blmonk/PoE-Stepper-Motor-Driver/README.md

# PoE-Stepper-Motor-Driver
ECE445 Senior Design
