blmonk/PoE-Stepper-Motor-Driver/(list of files, drawings)

Other design files:
boards/References/Analog Devices DC2911A/DC2911A/DC2911A-1_post/DC2911A-1.DSN
boards/References/Analog Devices DC2911A/DC2911A/DC2911A-1_post/DC2911A-1.PCB
