blmonk/PoE-Stepper-Motor-Driver/boards/PoE_Stepper_Driver/PoE_Stepper_Driver.kicad_pcb

## KiCad design boards/PoE_Stepper_Driver/PoE_Stepper_Driver.kicad_pcb (2022-05-06)

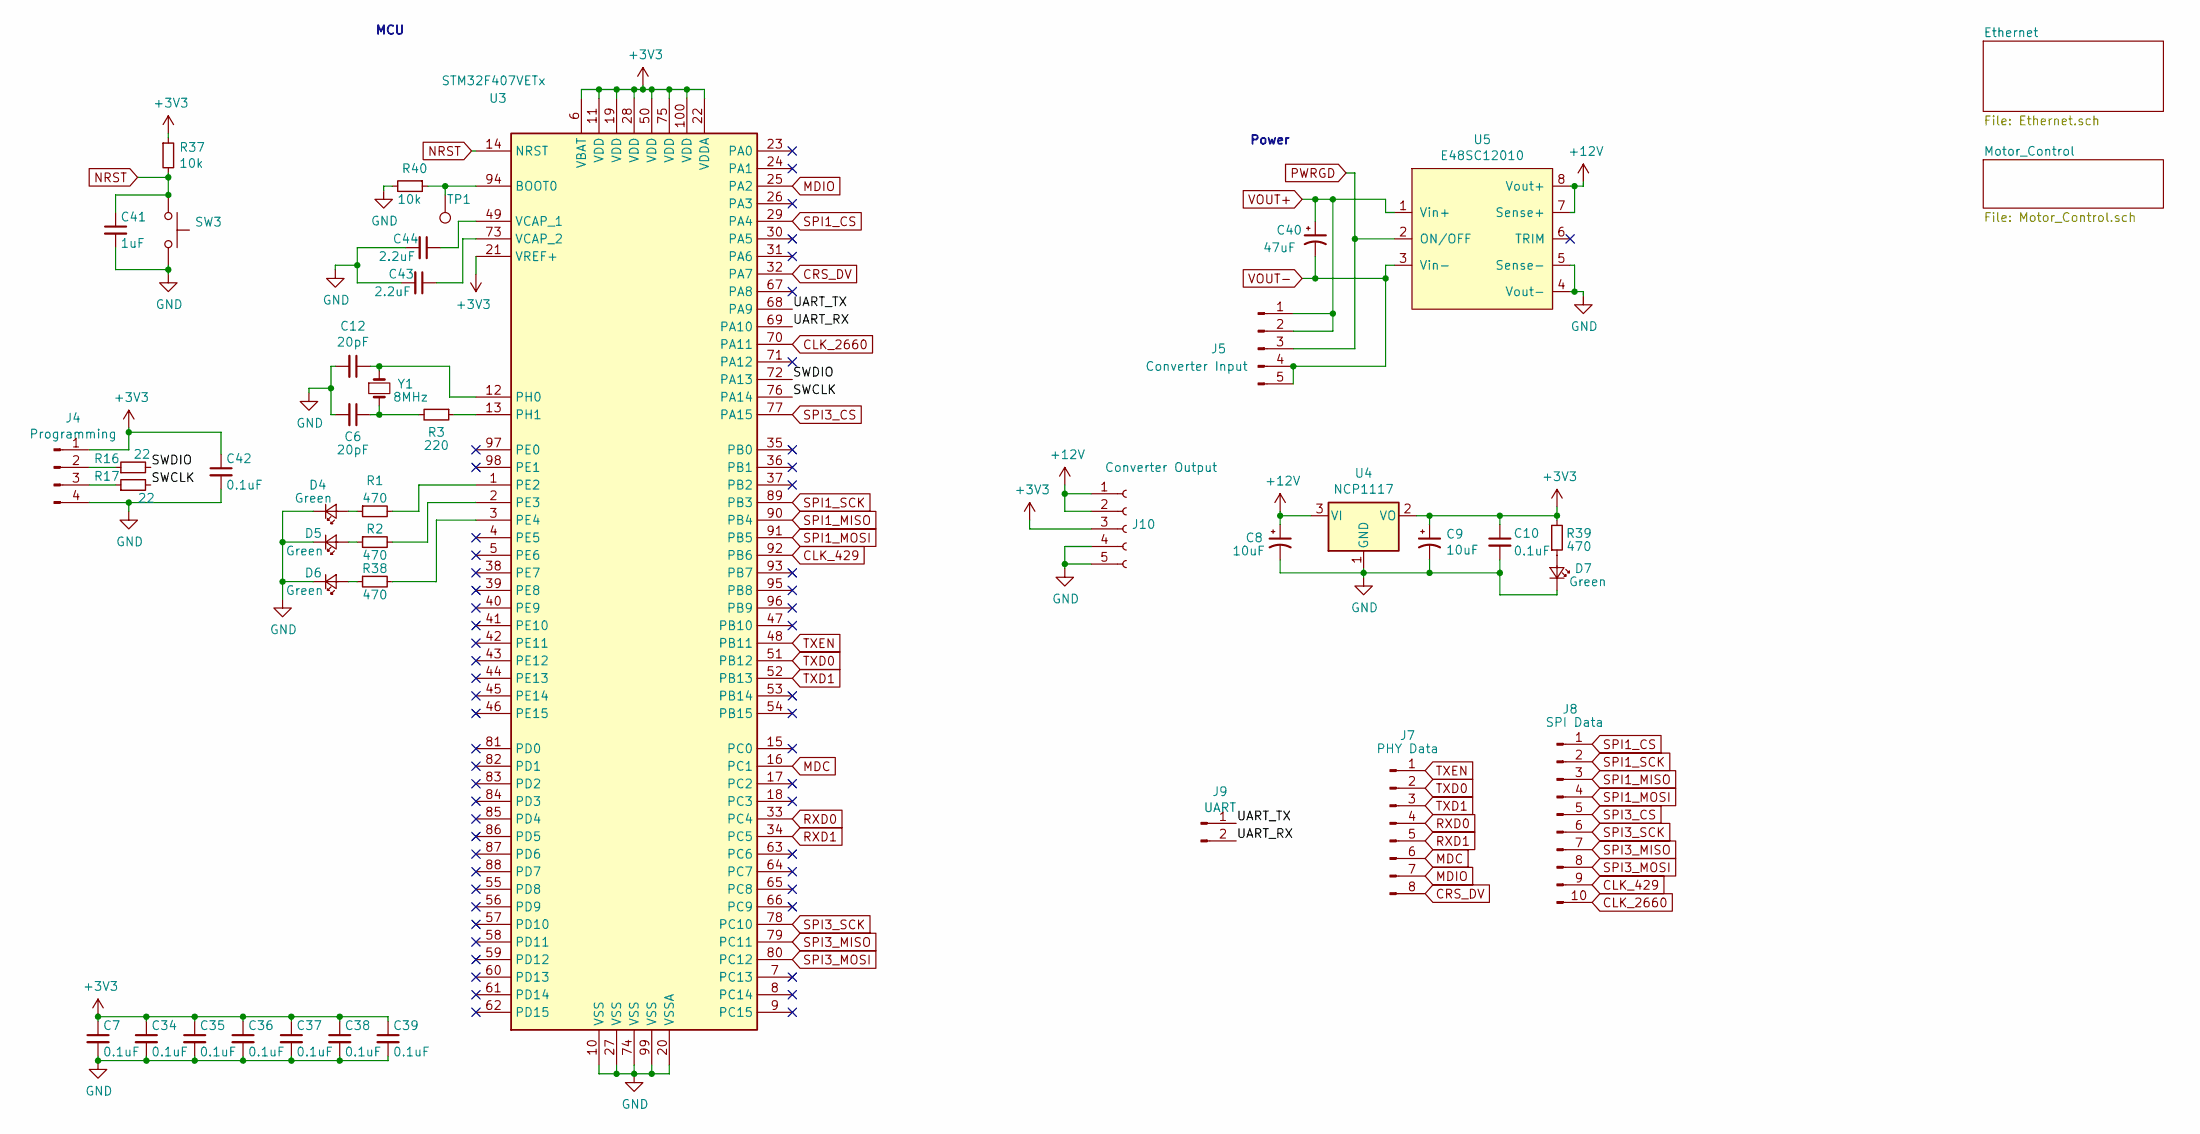
[picture p24: schematic PoE_Stepper_Driver.sch, PoE Stepper Driver]

Parts:
C6, C12: 20pF; C_0603_1608Metric_Pad1.05x0.95mm_HandSolder
C7, C10, C34, C35, C36, C37, C38, C39, C42: 0.1uF; C_0805_2012Metric_Pad1.15x1.40mm_HandSolder
C8, C9: 10uF; CP_Elec_6.3x5.4
C40: 47uF; CP_Radial_D8.0mm_P3.50mm
C41: 1uF; C_0805_2012Metric_Pad1.15x1.40mm_HandSolder
C43, C44: 2.2uF; C_0603_1608Metric_Pad1.05x0.95mm_HandSolder
D4, D5, D6, D7: Green; LED_0805_2012Metric_Pad1.15x1.40mm_HandSolder
J4: Programming; PinHeader_1x04_P2.54mm_Vertical
J5: Converter Input; PinHeader_1x05_P2.54mm_Vertical
J7: PHY Data; PinHeader_2x04_P2.54mm_Vertical
J8: SPI Data; PinHeader_2x05_P2.54mm_Vertical
J9: UART; PinHeader_1x02_P2.54mm_Vertical
J10: Converter Output; PinHeader_1x05_P2.54mm_Vertical
R1, R2, R38, R39: 470; R_0805_2012Metric_Pad1.15x1.40mm_HandSolder
R3: 220; R_0603_1608Metric_Pad1.05x0.95mm_HandSolder
R16, R17: 22; R_0805_2012Metric_Pad1.15x1.40mm_HandSolder
R37, R40: 10k; R_0805_2012Metric_Pad1.15x1.40mm_HandSolder
SW3: SW_Push; SW_SPST_B3S-1000
TP1: BOOT0; TestPoint_Pad_1.0x1.0mm
U3: STM32F407VETx; LQFP-100_14x14mm_P0.5mm
U4: NCP1117; SOT-223-3_TabPin2
U5: E48SC12010
Y1: 8MHz; Crystal_HC49-4H_Vertical

Connections:
+3V3: C7.1, C9.1, C10.1, C34.1, C35.1, C36.1, C37.1, C38.1, C39.1, C42.1, J4.1, J10.3, R37.1, R39.2, U3.6 (VBAT), U3.11 (VDD), U3.19 (VDD), U3.21 (VREF+), U3.22 (VDDA), U3.28 (VDD), U3.50 (VDD), U3.75 (VDD), U3.100 (VDD), U4.2 (VO); also elsewhere on the board
+12V: C8.1, J10.1, J10.2, U4.3 (VI), U5.7 (Sense+), U5.8 (Vout+); also elsewhere on the board
/SWCLK: R17.2, U3.76 (PA14)
/SWDIO: R16.2, U3.72 (PA13)
/UART_RX: J9.2, U3.69 (PA10)
/UART_TX: J9.1, U3.68 (PA9)
CLK_429: J8.9, U3.92 (PB6); also elsewhere on the board
CLK_2660: J8.10, U3.70 (PA11); also elsewhere on the board
CRS_DV: J7.8, U3.32 (PA7); also elsewhere on the board
GND: C6.2, C7.2, C8.2, C9.2, C10.2, C12.2, C34.2, C35.2, C36.2, C37.2, C38.2, C39.2, C41.2, C42.2, C43.2, C44.2, D4.1 (K), D5.1 (K), D6.1 (K), D7.1 (K), J4.4, J10.4, J10.5, R40.2, SW3.2, U3.10 (VSS), U3.20 (VSSA), U3.27 (VSS), U3.74 (VSS), U3.99 (VSS), U4.1 (GND), U5.4 (Vout-), U5.5 (Sense-); also elsewhere on the board
MDC: J7.6, U3.16 (PC1); also elsewhere on the board
MDIO: J7.7, U3.25 (PA2); also elsewhere on the board
NRST: C41.1, R37.2, SW3.1, U3.14 (NRST); also elsewhere on the board
unnamed: C6.1, R3.2, Y1.2
unnamed: C12.1, U3.12 (PH0), Y1.1
unnamed: C43.1, U3.73 (VCAP_2)
unnamed: C44.1, U3.49 (VCAP_1)
unnamed: D4.2 (A), R1.1
unnamed: D5.2 (A), R2.1
unnamed: D6.2 (A), R38.1
unnamed: D7.2 (A), R39.1
unnamed: J4.2, R16.1
unnamed: J4.3, R17.1
unnamed: R1.2, U3.1 (PE2)
unnamed: R2.2, U3.2 (PE3)
unnamed: R3.1, U3.13 (PH1)
unnamed: R38.2, U3.3 (PE4)
unnamed: R40.1, TP1.1, U3.94 (BOOT0)
PWRGD: J5.3, U5.2 (ON/OFF); also elsewhere on the board
RXD0: J7.4, U3.33 (PC4); also elsewhere on the board
RXD1: J7.5, U3.34 (PC5); also elsewhere on the board
SPI1_CS: J8.1, U3.29 (PA4); also elsewhere on the board
SPI1_MISO: J8.3, U3.90 (PB4); also elsewhere on the board
SPI1_MOSI: J8.4, U3.91 (PB5); also elsewhere on the board
SPI1_SCK: J8.2, U3.89 (PB3); also elsewhere on the board
SPI3_CS: J8.5, U3.77 (PA15); also elsewhere on the board
SPI3_MISO: J8.7, U3.79 (PC11); also elsewhere on the board
SPI3_MOSI: J8.8, U3.80 (PC12); also elsewhere on the board
SPI3_SCK: J8.6, U3.78 (PC10); also elsewhere on the board
TXD0: J7.2, U3.51 (PB12); also elsewhere on the board
TXD1: J7.3, U3.52 (PB13); also elsewhere on the board
TXEN: J7.1, U3.48 (PB11); also elsewhere on the board
VOUT+: C40.1, J5.1, J5.2, U5.1 (Vin+); also elsewhere on the board
VOUT-: C40.2, J5.4, J5.5, U5.3 (Vin-); also elsewhere on the board

Notes on the sheet:
Power
MCU

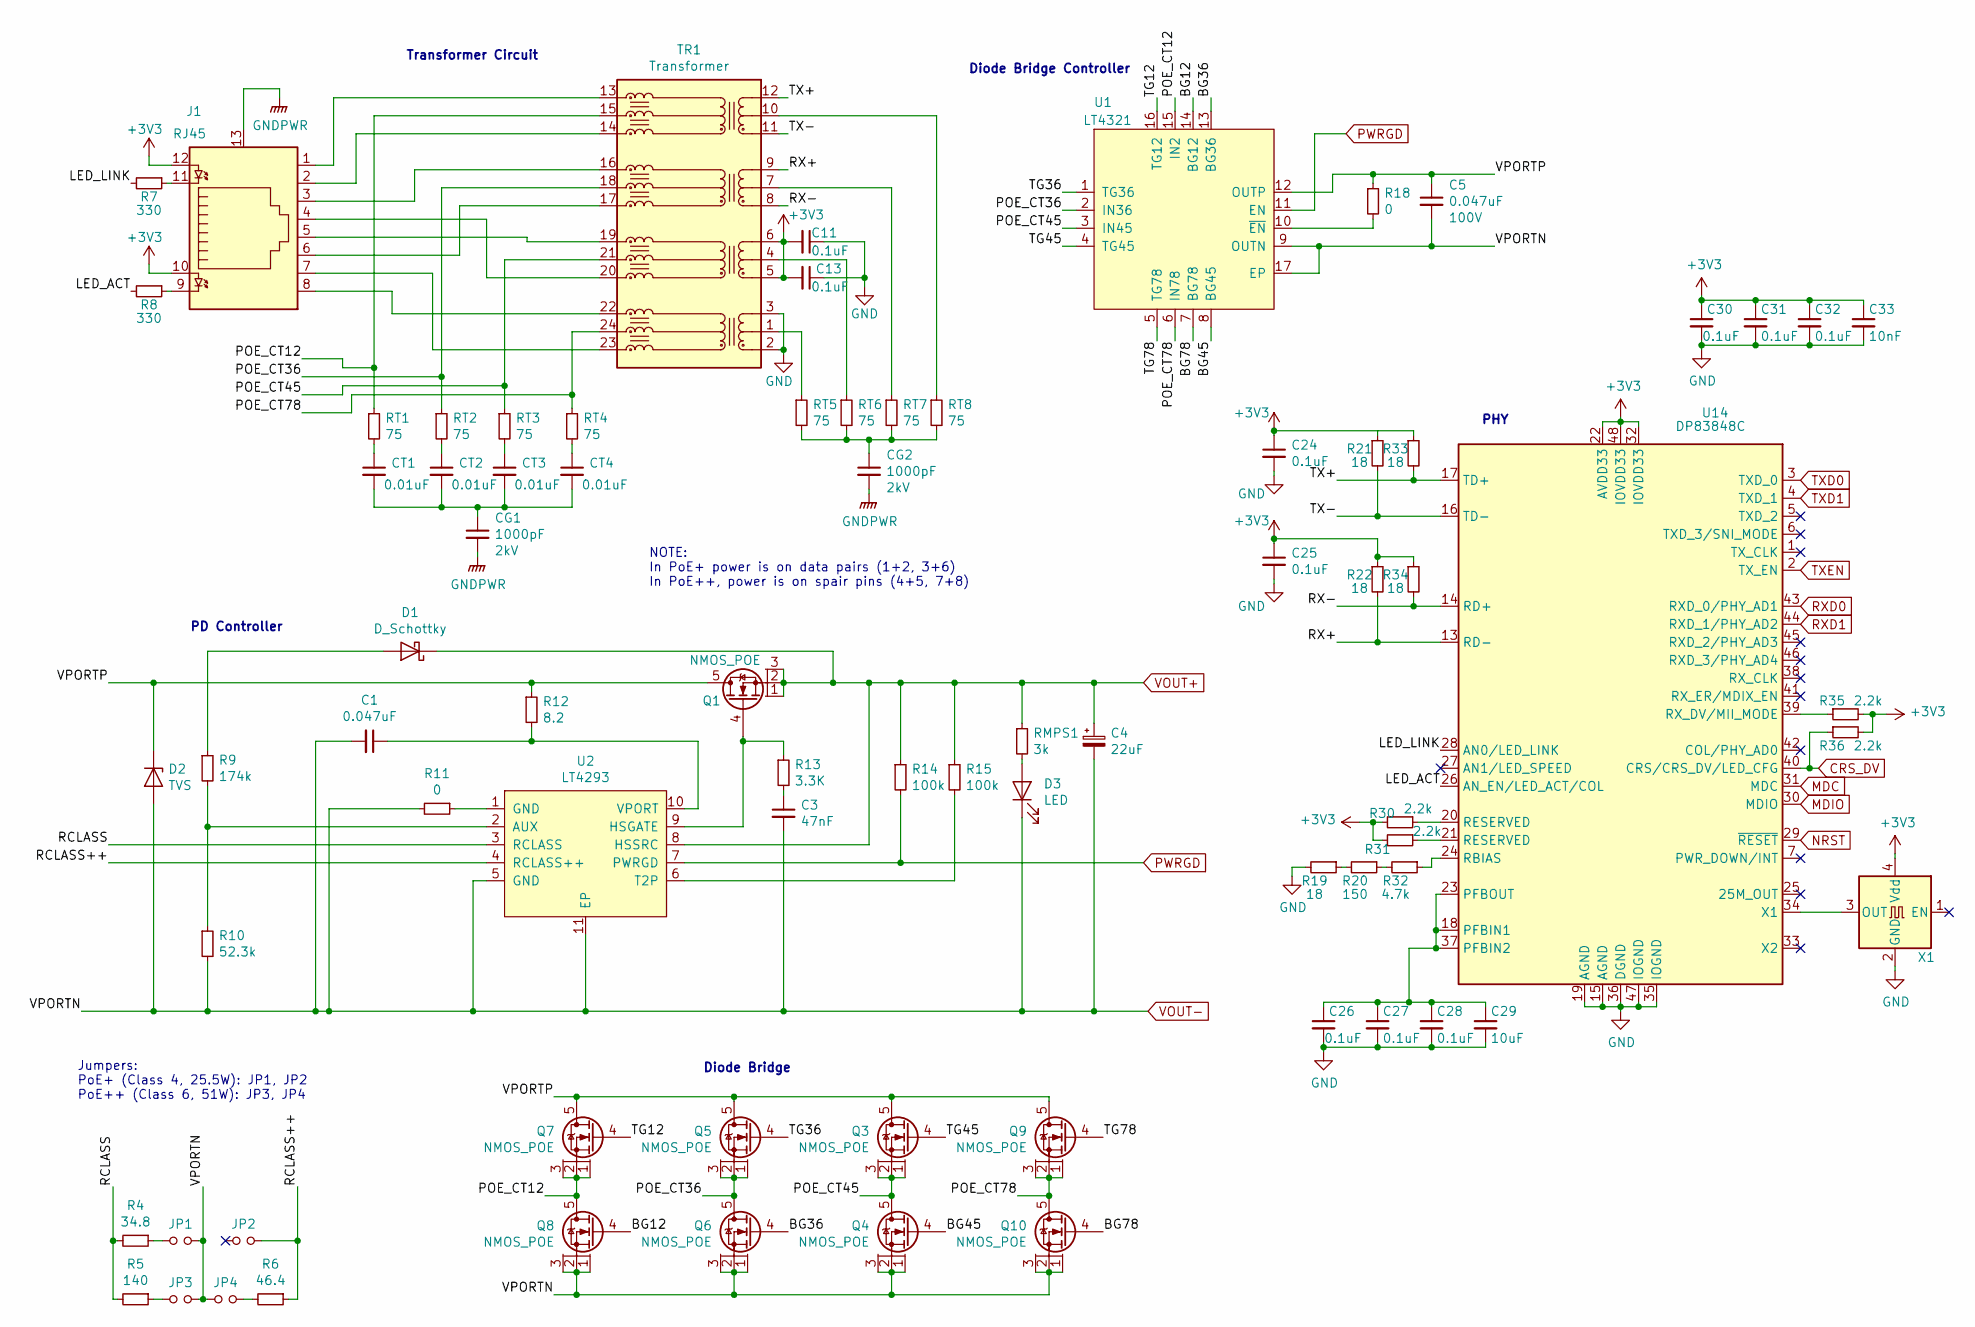
[picture p25: schematic Ethernet.sch, PoE Stepper Driver]

Parts:
C1: 0.047uF; C_0603_1608Metric_Pad1.05x0.95mm_HandSolder
C3: 47nF; C_0805_2012Metric_Pad1.15x1.40mm_HandSolder
C4: 22uF; CP_Elec_8x10.5
C5: 0.047uF; C_0603_1608Metric_Pad1.05x0.95mm_HandSolder; Voltage 100V
C11, C13, C24, C25, C26, C27, C28, C30, C31, C32: 0.1uF; C_0805_2012Metric_Pad1.15x1.40mm_HandSolder
C29: 10uF; C_0805_2012Metric_Pad1.15x1.40mm_HandSolder
C33: 10nF; C_0805_2012Metric_Pad1.15x1.40mm_HandSolder
CG1, CG2: 1000pF; C_1812_4532Metric_Pad1.30x3.40mm_HandSolder; Voltage 2kV
CT1, CT2, CT3, CT4: 0.01uF; C_0805_2012Metric_Pad1.15x1.40mm_HandSolder
D1: D_Schottky; D_SOD-128
D2: TVS; D_SOD-128
D3: LED; LED_0805_2012Metric_Pad1.15x1.40mm_HandSolder
J1: RJ45; RJ45_Amphenol_RJMG1BD3B8K1ANR
JP1, JP2, JP3, JP4: Jumper_NO_Small; PinHeader_1x02_P2.54mm_Vertical
Q1, Q3, Q4, Q5, Q6, Q7, Q8, Q9, Q10: NMOS_POE; LFPAK33
R4: 34.8; R_0805_2012Metric_Pad1.15x1.40mm_HandSolder
R5: 140; R_0805_2012Metric_Pad1.15x1.40mm_HandSolder
R6: 46.4; R_0805_2012Metric_Pad1.15x1.40mm_HandSolder
R7, R8: 330; R_0805_2012Metric_Pad1.15x1.40mm_HandSolder
R9: 174k; R_0603_1608Metric_Pad1.05x0.95mm_HandSolder
R10: 52.3k; R_0603_1608Metric_Pad1.05x0.95mm_HandSolder
R11, R18: 0; R_0603_1608Metric_Pad1.05x0.95mm_HandSolder
R12: 8.2; R_0805_2012Metric_Pad1.15x1.40mm_HandSolder
R13: 3.3K; R_0603_1608Metric_Pad1.05x0.95mm_HandSolder
R14, R15: 100k; R_0603_1608Metric_Pad1.05x0.95mm_HandSolder
R19, R21, R22, R33, R34: 18; R_0805_2012Metric_Pad1.15x1.40mm_HandSolder
R20: 150; R_0805_2012Metric_Pad1.15x1.40mm_HandSolder
R30, R31, R35, R36: 2.2k; R_0805_2012Metric_Pad1.15x1.40mm_HandSolder
R32: 4.7k; R_0805_2012Metric_Pad1.15x1.40mm_HandSolder
RMPS1: 3k; R_2512_6332Metric_Pad1.52x3.35mm_HandSolder
RT1, RT2, RT3, RT4, RT5, RT6, RT7, RT8: 75; R_0603_1608Metric_Pad1.05x0.95mm_HandSolder
TR1: Transformer; PoE_Transformer
U1: LT4321; QFN-16-1EP_4x4mm_P0.65mm_EP2.15x2.15mm
U2: LT4293; MSOP-10_3x3mm_P0.5mm
U14: DP83848C; LQFP-48_7x7mm_P0.5mm
X1: SXO53C

Connections:
+3V3: C11.2, C13.2, C24.1, C25.1, C30.1, C31.1, C32.1, C33.1, J1.10, J1.12, R21.1, R22.1, R30.2, R31.2, R33.1, R34.1, R35.2, R36.2, TR1.5 (TD2+), TR1.6 (TD2-), U14.22 (AVDD33), U14.32 (IOVDD33), U14.48 (IOVDD33), X1.4 (Vdd); also elsewhere on the board
/Ethernet/BG12: Q8.4, U1.14 (BG12)
/Ethernet/BG36: Q6.4, U1.13 (BG36)
/Ethernet/BG45: Q4.4, U1.8 (BG45)
/Ethernet/BG78: Q10.4, U1.7 (BG78)
/Ethernet/LED_ACT: R8.2, U14.26 (AN_EN/LED_ACT/COL)
/Ethernet/LED_LINK: R7.2, U14.28 (AN0/LED_LINK)
/Ethernet/POE_CT12: Q7.1, Q7.2, Q7.3, Q8.5, RT1.1, TR1.15 (MCT4), U1.15 (IN2)
/Ethernet/POE_CT36: Q5.1, Q5.2, Q5.3, Q6.5, RT2.1, TR1.18 (MCT3), U1.2 (IN36)
/Ethernet/POE_CT45: Q3.1, Q3.2, Q3.3, Q4.5, RT3.1, TR1.21 (MCT2), U1.3 (IN45)
/Ethernet/POE_CT78: Q9.1, Q9.2, Q9.3, Q10.5, RT4.1, TR1.24 (MTC1), U1.6 (IN78)
/Ethernet/RCLASS: R4.2, R5.2, U2.3 (RCLASS)
/Ethernet/RCLASS++: JP2.2, R6.1, U2.4 (RCLASS++)
/Ethernet/RX+: R22.2, TR1.9 (TD3-), U14.13 (RD-)
/Ethernet/RX-: R34.2, TR1.8 (TD3+), U14.14 (RD+)
/Ethernet/TG12: Q7.4, U1.16 (TG12)
/Ethernet/TG36: Q5.4, U1.1 (TG36)
/Ethernet/TG45: Q3.4, U1.4 (TG45)
/Ethernet/TG78: Q9.4, U1.5 (TG78)
/Ethernet/TX+: R33.2, TR1.12 (TD4-), U14.17 (TD+)
/Ethernet/TX-: R21.2, TR1.11 (TD4+), U14.16 (TD-)
/Ethernet/VPORTP: C5.1, D2.1 (K), Q1.5, Q3.5, Q5.5, Q7.5, Q9.5, R12.1, R18.1, U1.12 (OUTP)
CRS_DV: R36.1, U14.40 (CRS/CRS_DV/LED_CFG); also elsewhere on the board
GND: C11.1, C13.1, C24.2, C25.2, C26.2, C27.2, C28.2, C29.2, C30.2, C31.2, C32.2, C33.2, R19.2, TR1.2 (TD1+), TR1.3 (TD1-), U14.15 (AGND), U14.19 (AGND), U14.35 (IOGND), U14.36 (DGND), U14.47 (IOGND), X1.2 (GND); also elsewhere on the board
GNDPWR: CG1.2, CG2.2, J1.13
MDC: U14.31 (MDC); also elsewhere on the board
MDIO: U14.30 (MDIO); also elsewhere on the board
NRST: U14.29 (~RESET~); also elsewhere on the board
unnamed: C1.1, R12.2, U2.10 (VPORT)
unnamed: C3.1, R13.2
unnamed: C26.1, C27.1, C28.1, C29.1, U14.18 (PFBIN1), U14.23 (PFBOUT), U14.37 (PFBIN2)
unnamed: CG1.1, CT1.2, CT2.2, CT3.2, CT4.2
unnamed: CG2.1, RT5.2, RT6.2, RT7.2, RT8.2
unnamed: CT1.1, RT1.2
unnamed: CT2.1, RT2.2
unnamed: CT3.1, RT3.2
unnamed: CT4.1, RT4.2
unnamed: D1.2 (A), R9.1
unnamed: D3.2 (A), RMPS1.2
unnamed: J1.1, TR1.13 (MX4-)
unnamed: J1.2, TR1.14 (MX4+)
unnamed: J1.3, TR1.16 (MTX3-)
unnamed: J1.4, TR1.20 (MTX2+)
unnamed: J1.5, TR1.19 (MTX2-)
unnamed: J1.6, TR1.17 (MTX3+)
unnamed: J1.7, TR1.23 (MTX1+)
unnamed: J1.8, TR1.22 (MTX1-)
unnamed: J1.9, R8.1
unnamed: J1.11, R7.1
unnamed: JP1.1, R4.1
unnamed: JP3.1, R5.1
unnamed: JP4.2, R6.2
unnamed: Q1.4, R13.1, U2.9 (HSGATE)
unnamed: R9.2, R10.1, U2.2 (AUX)
unnamed: R11.1, U2.1 (GND)
unnamed: R15.2, U2.6 (T2P)
unnamed: R18.2, U1.10 (~EN)
unnamed: R19.1, R20.2
unnamed: R20.1, R32.2
unnamed: R30.1, U14.20 (RESERVED)
unnamed: R31.1, U14.21 (RESERVED)
unnamed: R32.1, U14.24 (RBIAS)
unnamed: R35.1, U14.39 (RX_DV/MII_MODE)
unnamed: RT5.1, TR1.1 (TCT1)
unnamed: RT6.1, TR1.4 (TCT2)
unnamed: RT7.1, TR1.7 (TCT3)
unnamed: RT8.1, TR1.10 (TCT4)
unnamed: U14.34 (X1), X1.3 (OUT)
PWRGD: R14.2, U1.11 (EN), U2.7 (PWRGD); also elsewhere on the board
RXD0: U14.43 (RXD_0/PHY_AD1); also elsewhere on the board
RXD1: U14.44 (RXD_1/PHY_AD2); also elsewhere on the board
TXD0: U14.3 (TXD_0); also elsewhere on the board
TXD1: U14.4 (TXD_1); also elsewhere on the board
TXEN: U14.2 (TX_EN); also elsewhere on the board
VOUT+: C4.1, D1.1 (K), Q1.1, Q1.2, Q1.3, R14.1, R15.1, RMPS1.1, U2.8 (HSSRC); also elsewhere on the board
VOUT-: C1.2, C3.2, C4.2, C5.2, D2.2 (A), D3.1 (K), JP1.2, JP3.2, JP4.1, Q4.1, Q4.2, Q4.3, Q6.1, Q6.2, Q6.3, Q8.1, Q8.2, Q8.3, Q10.1, Q10.2, Q10.3, R10.2, R11.2, U1.9 (OUTN), U1.17 (EP), U2.5 (GND), U2.11 (EP); also elsewhere on the board

Notes on the sheet:
Jumpers: PoE+ (Class 4, 25.5W): JP1, JP2 PoE++ (Class 6, 51W): JP3, JP4
Diode Bridge Controller
Transformer Circuit
PD Controller
Diode Bridge
NOTE: In PoE+ power is on data pairs (1+2, 3+6) In PoE++, power is on spair pins (4+5, 7+8)
PHY

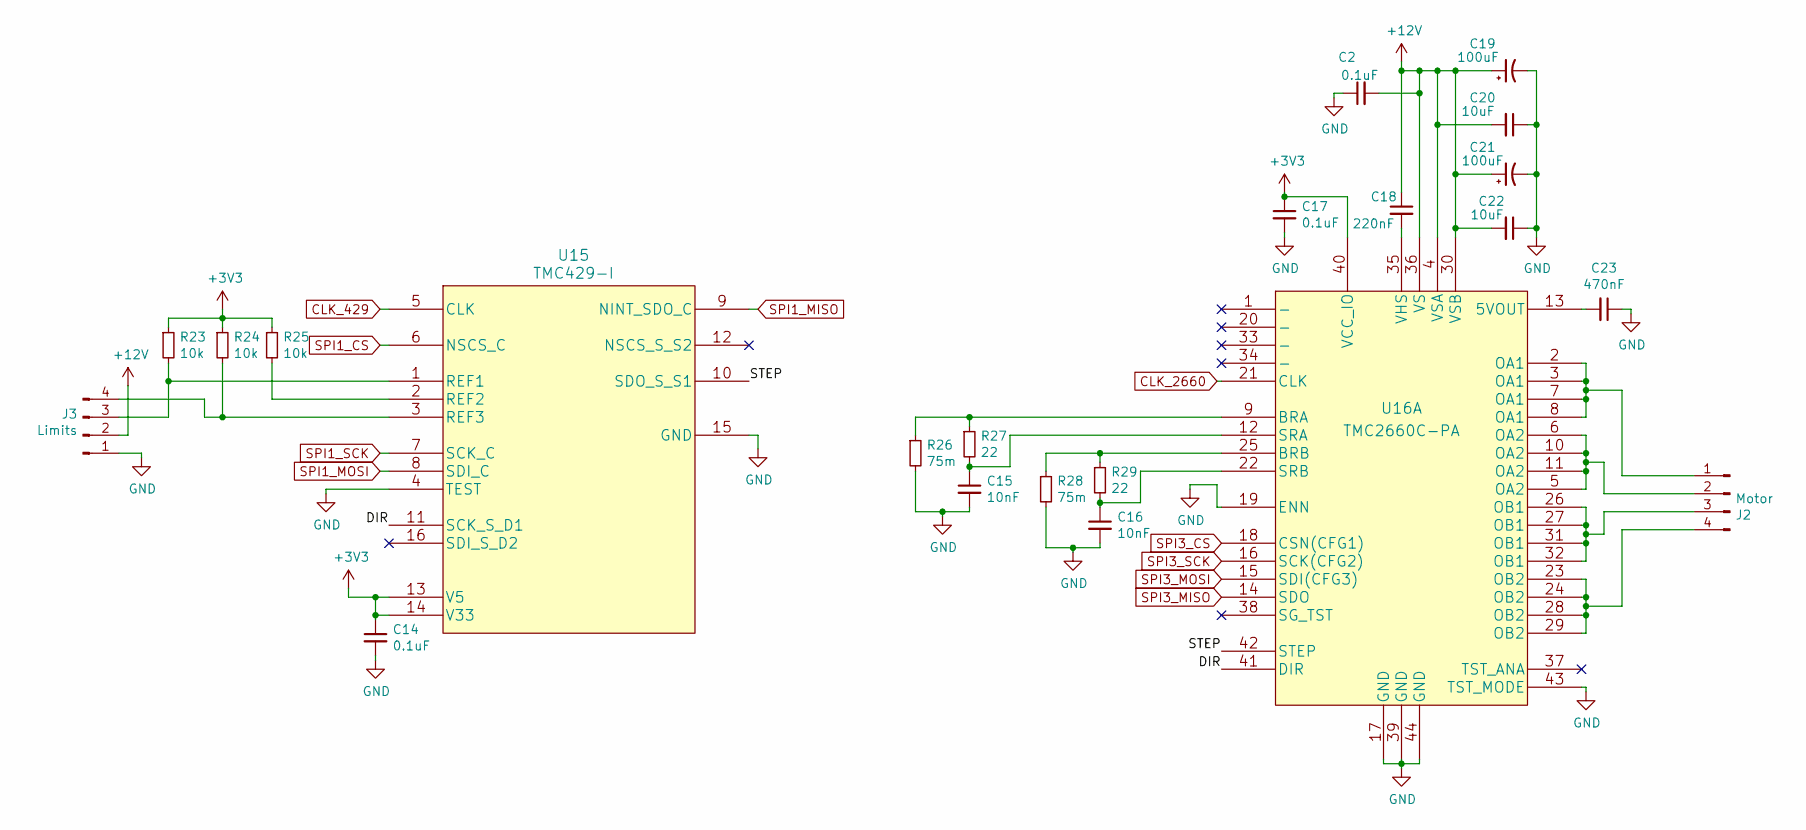
[picture p26: schematic Motor_Control.sch, PoE Stepper Driver]

Parts:
C2, C14, C17: 0.1uF; C_0805_2012Metric_Pad1.15x1.40mm_HandSolder
C15, C16: 10nF; C_0805_2012Metric_Pad1.15x1.40mm_HandSolder
C18: 220nF; C_0805_2012Metric_Pad1.15x1.40mm_HandSolder
C19, C21: 100uF; CP_Radial_D8.0mm_P3.50mm
C20, C22: 10uF; C_1206_3216Metric_Pad1.42x1.75mm_HandSolder
C23: 470nF; C_0805_2012Metric_Pad1.15x1.40mm_HandSolder
J2: Motor; JST_PH_B4B-PH-K_1x04_P2.00mm_Vertical
J3: Limits; JST_PH_B4B-PH-K_1x04_P2.00mm_Vertical
R23, R24, R25: 10k; R_0805_2012Metric_Pad1.15x1.40mm_HandSolder
R26, R28: 75m; R_2010_5025Metric_Pad1.52x2.65mm_HandSolder
R27, R29: 22; R_0805_2012Metric_Pad1.15x1.40mm_HandSolder
U15: TMC429-I; SSOP-16_3.9x4.9mm_P0.635mm
U16: TMC2660C-PA; PQFP-44_10x10mm_P0.8mm

Connections:
+3V3: C14.1, C17.1, R23.1, R24.1, R25.1, U15.13 (V5), U15.14 (V33), U16.40 (VCC_IO); also elsewhere on the board
+12V: C2.2, C18.1, C19.1, C20.2, C21.1, C22.2, J3.2, U16.4 (VSA), U16.30 (VSB), U16.36 (VS); also elsewhere on the board
/Motor_Control/DIR: U15.11 (SCK_S_D1), U16.41 (DIR)
/Motor_Control/STEP: U15.10 (SDO_S_S1), U16.42 (STEP)
CLK_429: U15.5 (CLK); also elsewhere on the board
CLK_2660: U16.21 (CLK); also elsewhere on the board
GND: C2.1, C14.2, C15.2, C16.2, C17.2, C19.2, C20.1, C21.2, C22.1, C23.1, J3.1, R26.2, R28.2, U15.4 (TEST), U15.15 (GND), U16.17 (GND), U16.19 (ENN), U16.39 (GND), U16.43 (TST_MODE), U16.44 (GND); also elsewhere on the board
unnamed: C15.1, R27.2, U16.12 (SRA)
unnamed: C16.1, R29.2, U16.22 (SRB)
unnamed: C18.2, U16.35 (VHS)
unnamed: C23.2, U16.13 (5VOUT)
unnamed: J2.1, U16.2 (OA1), U16.3 (OA1), U16.7 (OA1), U16.8 (OA1)
unnamed: J2.2, U16.5 (OA2), U16.6 (OA2), U16.10 (OA2), U16.11 (OA2)
unnamed: J2.3, U16.26 (OB1), U16.27 (OB1), U16.31 (OB1), U16.32 (OB1)
unnamed: J2.4, U16.23 (OB2), U16.24 (OB2), U16.28 (OB2), U16.29 (OB2)
unnamed: J3.3, R23.2, U15.1 (REF1)
unnamed: J3.4, R24.2, U15.3 (REF3)
unnamed: R25.2, U15.2 (REF2)
unnamed: R26.1, R27.1, U16.9 (BRA)
unnamed: R28.1, R29.1, U16.25 (BRB)
SPI1_CS: U15.6 (NSCS_C); also elsewhere on the board
SPI1_MISO: U15.9 (NINT_SDO_C); also elsewhere on the board
SPI1_MOSI: U15.8 (SDI_C); also elsewhere on the board
SPI1_SCK: U15.7 (SCK_C); also elsewhere on the board
SPI3_CS: U16.18 (CSN(CFG1)); also elsewhere on the board
SPI3_MISO: U16.14 (SDO); also elsewhere on the board
SPI3_MOSI: U16.15 (SDI(CFG3)); also elsewhere on the board
SPI3_SCK: U16.16 (SCK(CFG2)); also elsewhere on the board

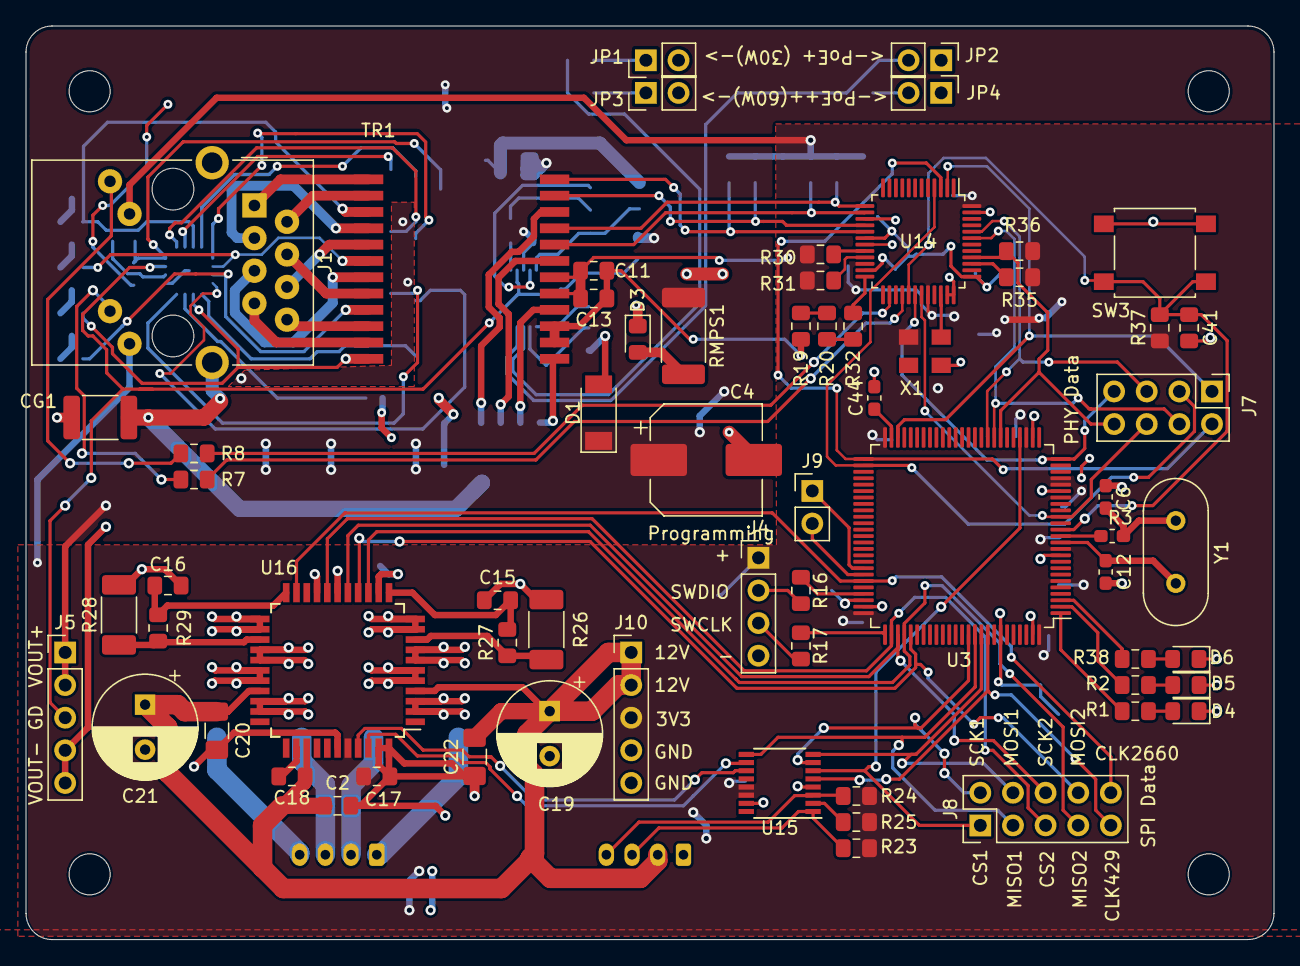
[picture p27: board PoE_Stepper_Driver.kicad_pcb from above]

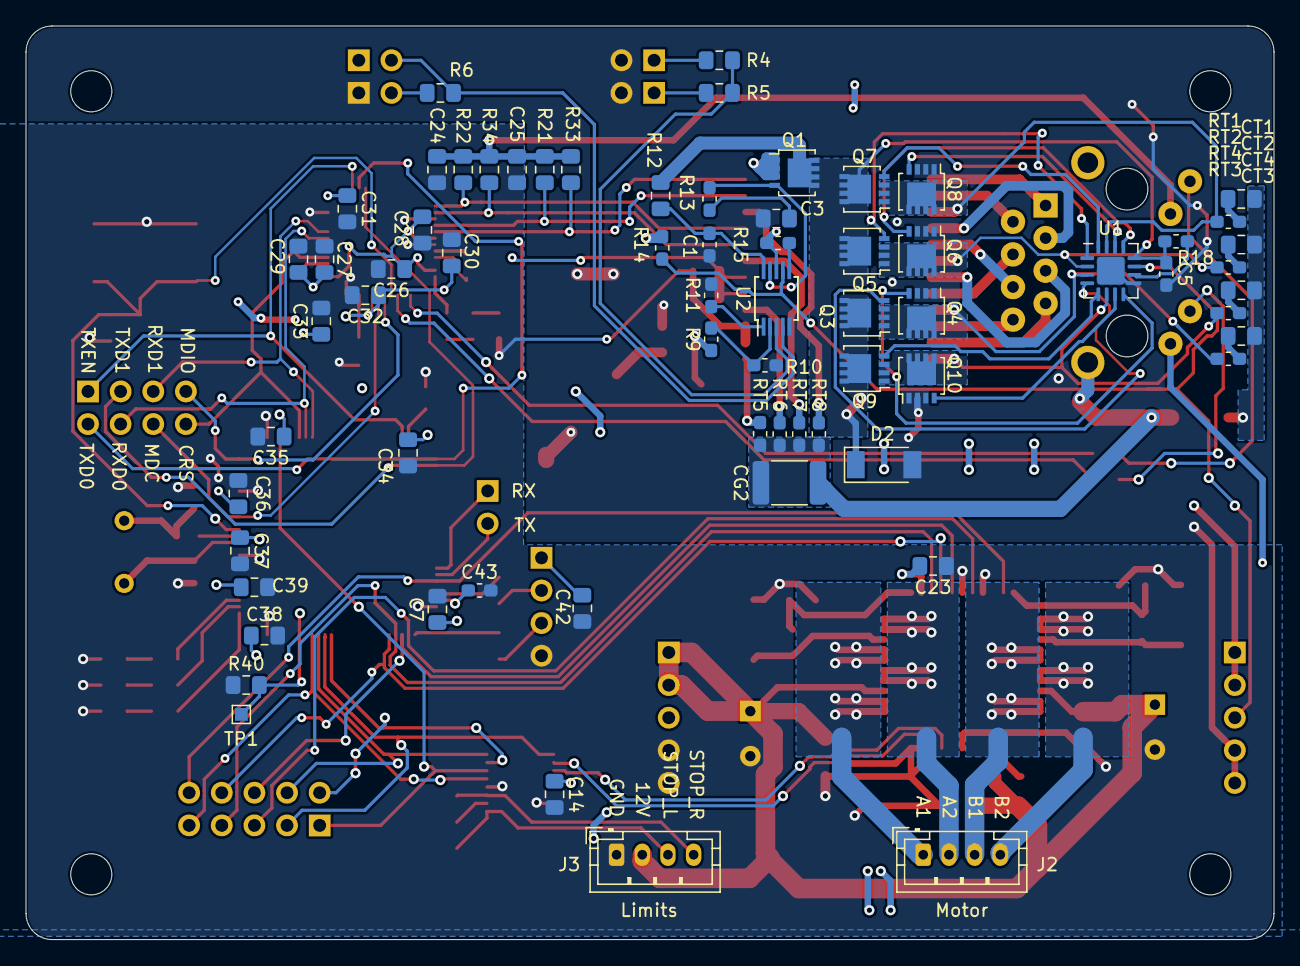
[picture p28: board PoE_Stepper_Driver.kicad_pcb from below]

Board: 2 copper layers, 97.2 x 71.1 mm, 133 parts (68 on the bottom side), 120 nets.
