blmonk/PoE-Stepper-Motor-Driver/boards/PoE_Stepper_Driver/Power_Board.kicad_pcb

## KiCad design boards/PoE_Stepper_Driver/Power_Board.kicad_pcb (2022-05-06)

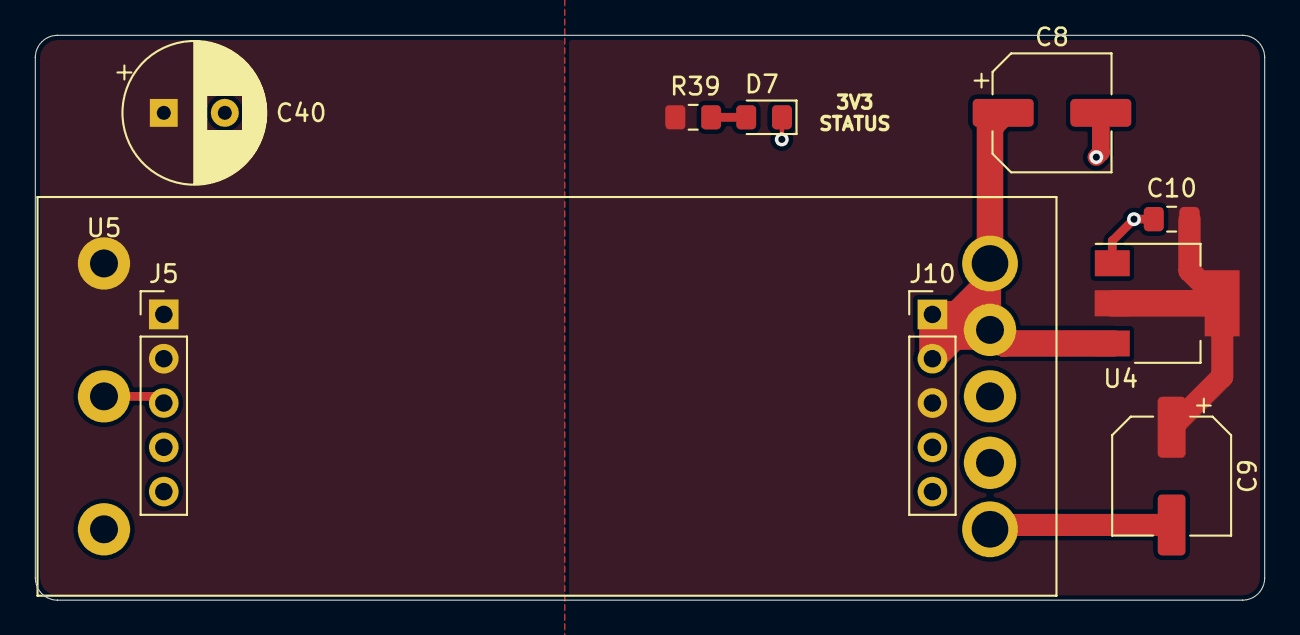
[picture p29: board Power_Board.kicad_pcb from above]

Board: 2 copper layers, 70.5 x 32.4 mm, 10 parts (0 on the bottom side), 7 nets.

Parts:
C8, C9: 10uF; CP_Elec_6.3x5.4
C10: 0.1uF; C_0805_2012Metric_Pad1.15x1.40mm_HandSolder
C40: 47uF; CP_Radial_D8.0mm_P3.50mm
D7: Green; LED_0805_2012Metric_Pad1.15x1.40mm_HandSolder
J5: Converter Input; PinHeader_1x05_P2.54mm_Vertical
J10: Converter Output; PinHeader_1x05_P2.54mm_Vertical
R39: 470; R_0805_2012Metric_Pad1.15x1.40mm_HandSolder
U4: NCP1117; SOT-223-3_TabPin2
U5: E48SC12010

Connections:
+3V3: C9.1, C10.1, J10.3, R39.2, U4.2
+12V: C8.1, J10.1, J10.2, U4.3, U5.7, U5.8
GND: C8.2, C9.2, C10.2, D7.1, J10.4, J10.5, U4.1, U5.4, U5.5
unnamed: D7.2, R39.1
PWRGD: J5.3, U5.2
VOUT+: C40.1, J5.1, J5.2, U5.1
VOUT-: C40.2, J5.4, J5.5, U5.3
