blmonk/PoE-Stepper-Motor-Driver/boards/PoE_Stepper_Driver/FET_Board.kicad_pcb

## KiCad design boards/PoE_Stepper_Driver/FET_Board.kicad_pcb (2022-03-30)

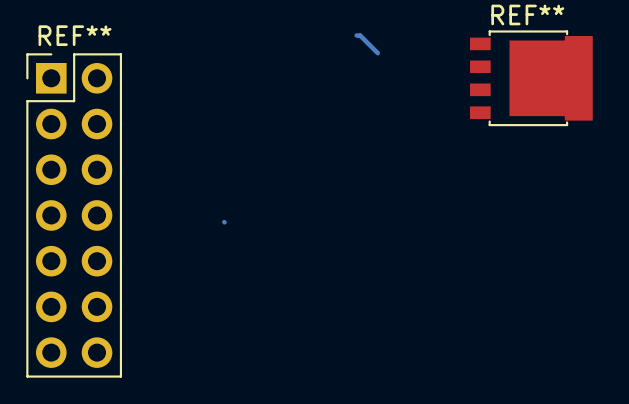
[picture p30: board FET_Board.kicad_pcb from above]

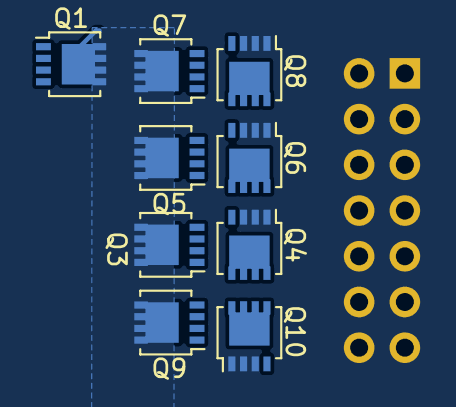
[picture p31: board FET_Board.kicad_pcb from below]

Board: 2 copper layers, 9 parts (9 on the bottom side), 7 nets.

Parts:
Q1, Q3, Q4, Q5, Q6, Q7, Q8, Q9, Q10: NMOS_POE; LFPAK33

Connections:
/Ethernet/POE_CT12: Q7.1, Q7.2, Q7.3, Q8.5
/Ethernet/POE_CT36: Q5.1, Q5.2, Q5.3, Q6.5
/Ethernet/POE_CT45: Q3.1, Q3.2, Q3.3, Q4.5
/Ethernet/POE_CT78: Q9.1, Q9.2, Q9.3, Q10.5
/Ethernet/VPORTP: Q1.5, Q3.5, Q5.5, Q7.5, Q9.5
VOUT+: Q1.1, Q1.2, Q1.3
VOUT-: Q4.1, Q4.2, Q4.3, Q6.1, Q6.2, Q6.3, Q8.1, Q8.2, Q8.3, Q10.1, Q10.2, Q10.3
