blmonk/PoE-Stepper-Motor-Driver/code/FINAL CODE/PoE_Stepper_VGT/Core/Src/main.c

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
/* Includes ------------------------------------------------------------------*/
#include "main.h"
#include "lwip.h"

/* USER CODE BEGIN Includes */
#include <stdio.h>
/* USER CODE END Includes */

SPI_HandleTypeDef hspi1;
SPI_HandleTypeDef hspi3;

TIM_HandleTypeDef htim4;

UART_HandleTypeDef huart1;
DMA_HandleTypeDef hdma_usart1_rx;

void SystemClock_Config(void);
static void MX_GPIO_Init(void);
static void MX_SPI1_Init(void);
static void MX_SPI3_Init(void);
static void MX_TIM4_Init(void);
static void MX_DMA_Init(void);
static void MX_USART1_UART_Init(void);
/* USER CODE BEGIN PFP */
uint8_t SPI_2660_Init(void);
uint8_t SPI_429_Init(uint8_t *spi_buf);
void const_vel_test_429 (uint8_t * spi_buf);
void const_vel_test_429_pos (uint8_t * spi_buf);
void set_motor_pos(uint32_t position, uint8_t * spi_buf);
void read_position(uint8_t * spi_buffer, uint8_t reg);
void read_ifx(uint8_t * spi_buf);
void write_ifx(uint8_t * spi_buf);
void read_common_reg(uint8_t * spi_buf);


uint32_t set_current_scaling(uint8_t * c_scale);
uint32_t set_motor_x(uint8_t * pos, uint8_t * spi_buf);
uint32_t set_motor_vel(uint8_t * vel, uint8_t * spi_buf);
void get_position(uint8_t * spi_buf);
uint8_t* get_velocity(uint8_t * spi_buf);
void set_const_vel_test(uint8_t * spi_buf);
/* USER CODE END PFP */

/* USER CODE BEGIN 0 */
extern struct netif gnetif;
uint8_t Rx_data[10];  //  creating a buffer of 10 bytes


void HAL_UART_RxHalfCpltCallback(UART_HandleTypeDef *huart)
{
  HAL_GPIO_TogglePin(GPIOE, GPIO_PIN_4);  // toggle PA0
}

void HAL_UART_RxCpltCallback(UART_HandleTypeDef *huart)
{
  HAL_UART_Receive_DMA(&huart1, Rx_data, 4);
}

/* USER CODE END 0 */

/**
  * @brief  The application entry point.
  * @retval int
  */
int main(void)
{
  /* MCU Configuration--------------------------------------------------------*/

  /* Reset of all peripherals, Initializes the Flash interface and the Systick. */
  HAL_Init();

  /* Configure the system clock */
  SystemClock_Config();

  /* Initialize all configured peripherals */
  MX_GPIO_Init();
  MX_SPI1_Init();
  MX_SPI3_Init();
  MX_TIM4_Init();
  MX_DMA_Init();
  MX_USART1_UART_Init();
  MX_LWIP_Init();
  /* USER CODE BEGIN 2 */


  //  TIM1->CCR4 = 4; //set duty cycle of tim1 ch4
     //set duty cycle of tim4 ch1

    //HAL_TIM_PWM_Start(&htim1, TIM_CHANNEL_4); //start tim1 ch4 pwm

  //  HAL_TIM_Base_Start(&htim4);
  TIM4->CCR1 = 1;
  HAL_TIM_PWM_Start(&htim4, TIM_CHANNEL_1); //start tim4 ch1 pwm

  uint8_t spi_buf[4];


  SPI_429_Init(spi_buf);
  SPI_2660_Init();



  /* USER CODE END 2 */

  /* Infinite loop */
  /* USER CODE BEGIN WHILE */
  // read_ifx(spi_buf);

  HAL_UART_Receive_DMA(&huart1, Rx_data, 4);  // Receive 4 Bytes of data

  while (1)
  {
    /* USER CODE END WHILE */

    /* USER CODE BEGIN 3 */
//	int j;
//	j=0;
//	char MSG[500] = {'\0'};
//
//
//		sprintf(MSG, "RX_DATA:%x, %x, %x, %x \r\n", (Rx_data[0]), (Rx_data[1]), (Rx_data[2]), (Rx_data[3]));

	  //HAL_UART_Transmit(&huart1, (uint8_t *)Rx_data, 4, HAL_MAX_DELAY);

//	 ethernetif_input(&gnetif);
//	 sys_check_timeouts();



//	 read_common_reg(spi_buf);

	 switch (Rx_data[0]) {
		 case 0x01: // set pos

//			 HAL_GPIO_WritePin(GPIOE, GPIO_PIN_4, GPIO_PIN_SET);
			 set_motor_x(Rx_data, spi_buf);
			 break;

		 case 0x02: // get pos
			 get_position(spi_buf);
			 //set_const_vel_test(spi_buf);

			 break;

		 case 0x04: // set vel
			 set_motor_vel(Rx_data, spi_buf);
			 break;

		 case 0x08: // get vel
			 break;

		 case 0x0F: // set current scale
			 set_current_scaling(Rx_data);
			 break;

	 }

	 uint8_t test[4];
	 test[0] = Rx_data[0];
	 test[1] = Rx_data[1];
	 test[2] = Rx_data[2];
	 test[3] = Rx_data[3];

//	 HAL_Delay(1000);



//	 MSG[500] = {'\0'};
//	HAL_GPIO_TogglePin(GPIOE, GPIO_PIN_4);
//	HAL_Delay(50);
//	set_motor_pos(1, spi_buf);

  // read_ifx(spi_buf);
	//const_vel_test_429(spi_buf);
  //HAL_Delay(1000);
  //const_vel_test_429_pos(spi_buf);


//	HAL_GPIO_WritePin(GPIOA, GPIO_PIN_15, GPIO_PIN_RESET);
//	HAL_SPI_Transmit(&hspi3,(uint8_t *)spi_buf, 3, 100);
//	HAL_GPIO_WritePin(GPIOA, GPIO_PIN_15, GPIO_PIN_SET);



  }
  /* USER CODE END 3 */
}

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
/* USER CODE BEGIN 4 */


HAL_StatusTypeDef SPI_2660_Transmit(uint8_t * dataBuffer){
    HAL_StatusTypeDef err;
    uint8_t spi_buf[3];

    HAL_GPIO_WritePin(GPIOA, GPIO_PIN_15, GPIO_PIN_RESET);
    err = HAL_SPI_TransmitReceive(&hspi3, (uint8_t *)dataBuffer, (uint8_t *)spi_buf,  3, 100);
    while(HAL_SPI_GetState(&hspi3) != HAL_SPI_STATE_READY);
//    while(HAL_SPI_GetState(&hspi3) != HAL_SPI_STATE_READY);
    HAL_GPIO_WritePin(GPIOA, GPIO_PIN_15, GPIO_PIN_SET);

    return err;
}

uint8_t SPI_2660_Init(void){
    uint8_t wData[3];
    wData[0] = 0x09;            // SPI = $94557  Constant toff mode
    wData[1] = 0x01;
    wData[2] = 0xB4;
    SPI_2660_Transmit(wData);


    wData[0] = 0x0D;            // SPI = $D001F  Current setting: $d001F (max. current) (D000A = 1/3 current)
    wData[1] = 0x00;
    wData[2] = 0x0A;//0x0A;
    SPI_2660_Transmit(wData);

    wData[0] = 0x0E;            // SPI = $E0090  low driver strength, StallGuard2 read, SDOFF=1
    wData[1] = 0x00;            //  1110 0000 0000 1001 0000
    wData[2] = 0x10;
    SPI_2660_Transmit(wData);

    wData[0] = 0x00;            // SPI = $00000  256 microstep setting
    wData[1] = 0x00;
    wData[2] = 0x00; // 64 micro step setting // 0x00; 08-full
    SPI_2660_Transmit(wData);

    return 0;

}


HAL_StatusTypeDef SPI_429_Transmit(uint8_t * dataBuffer, uint8_t *spi_buf){
    HAL_StatusTypeDef err;
    // uint8_t spi_buf[4];


    HAL_GPIO_WritePin(GPIOE, GPIO_PIN_2, GPIO_PIN_RESET);
    err = HAL_SPI_TransmitReceive(&hspi1, (uint8_t *)dataBuffer, (uint8_t *)spi_buf,  4, 10000);
    while(HAL_SPI_GetState(&hspi1) != HAL_SPI_STATE_READY);
//  HAL_SPI_Receive(&hspi3, (uint8_t *)spi_buf, 5, 100);
//    while(HAL_SPI_GetState(&hspi3) != HAL_SPI_STATE_READY);
    HAL_GPIO_WritePin(GPIOE, GPIO_PIN_2, GPIO_PIN_SET);

    return err;
}

uint8_t SPI_429_Init(uint8_t *spi_buf){
    uint8_t wData[4];
    wData[0] = 0x04;            // SPI = $04 00 00 07
    wData[1] = 0x00;
    wData[2] = 0x00;
    wData[3] = 0x07;
    SPI_429_Transmit(wData,spi_buf);
    //0000 0100 0000 0000 0[000 0000 0111]
    //IDX: 0010
    //vmin: 7

    wData[0] = 0x06;            // SPI = $06 00 07 FF
    wData[1] = 0x00;
    wData[2] = 0x07;
    wData[3] = 0x00;
    SPI_429_Transmit(wData,spi_buf);
    //0000 0110 0000 0000 0[111 1111 1111]
    //IDX: 0011
    //vmax:2047

    wData[0] = 0x18;// end now 07 //0x14;            // SPI = $14 00 33 00
    wData[1] = 0x00;
    wData[2] = 0x33;
    wData[3] = 0x00;//0x07; //usrs res 111 64 microstep
    SPI_429_Transmit(wData, spi_buf);
    //0001 1000 0000 0000 [0011] [0011] 0000 [0111]
    //IDX:1100 18
    //PULSE_DIV: 3
    //RAMP_DIV: 3
    //USRS: 7


//    //NEW ADD
//    wData[0] = 0x14;            // SPI = $14 00 03 00
//    wData[1] = 0x00;
//    wData[2] = 0x03;            // ref_conf = (refrnl, softstop, disavle stop r. disable stop 1) = 0b011
//    wData[3] = 0x00;          //0x02;
//    SPI_429_Transmit(wData, spi_buf);
//    //0001 0100 0000 0000 0000 [0011] 0000 00[00]
//    //IDX: 1010
//    //REF_CONF = 3
//    //R_M = 2
//    //00-ramp mode(set pos), 01 soft mode, 10 velocity mode

    //ENABLE REFERENCE SWITCHES
    wData[0] = 0x14;            // SPI = $14 00 03 00
    wData[1] = 0x00;
    wData[2] = 0x00;            // ref_conf = (refrnl, softstop, disavle stop r. disable stop 1) = 0b011
    wData[3] = 0x00;          //0x02;
    SPI_429_Transmit(wData, spi_buf);

    wData[0] = 0x0C;            // SPI = $0C 00 00 0A
    wData[1] = 0x00;
    wData[2] = 0x00;
    wData[3] = 0x0A;
    SPI_429_Transmit(wData, spi_buf);
    //0000 1100 0000 0000 0000 0[000 0000 1010]
    //IDX:0110
    //A_MAX: 10


    wData[0] = 0x12;            // SPI = $12 00 1E 08
    wData[1] = 0x00;
    wData[2] = 0x1E;
    wData[3] = 0x08;
    SPI_429_Transmit(wData, spi_buf);
    //0001 0010 0000 0000 1[110 1000] 0000 [1000]
    //IDX:1001
    //1: 1
    //PMUL:158-128 = 30
    //PDIV:8

    wData[0] = 0x0A;            // SPI = $0A 00 03 00
    wData[1] = 0x00;
    wData[2] = 0x03;
    wData[3] = 0x00;
    SPI_429_Transmit(wData, spi_buf);
    //0000 1010 0000 0000 0000 [0011 0000 0000]
    //IDX:0101
    //VACTUAL: 768


//    //WRITE TO FX
//    wData[0] = 0x68;
//    wData[1] = 0x00;
//    wData[2] = 0x00;
//    wData[3] = 0x20;
//    //ENABLE step/dir mode

    //INVERSE REF SWITCH
    wData[0] = 0x68;
    wData[1] = 0x00;
    wData[2] = 0x00;
    wData[3] = 0x21;
    //ENABLE step/dir mode

    SPI_429_Transmit(wData, spi_buf);


//    set refmux, mot2r

    wData[0] = 0x7E;
    wData[1] = 0x20;
    wData[2] = 0x0F;
    wData[3] = 0x00;

    SPI_429_Transmit(wData, spi_buf);


    return 0;
    //64 micros/ full step       200 steps/ rev
}

void const_vel_test_429 (uint8_t * spi_buf){
	  uint8_t wData[4];

    wData[0] = 0x08;            // SPI = 0000 1000 0000 0000 0000 [0000 0001 0000]
    wData[1] = 0x00;
    wData[2] = 0x00;
    wData[3] = 0x10;
    SPI_429_Transmit(wData, spi_buf);

    read_position(spi_buf, 1);
}


void read_common_reg(uint8_t * spi_buf){

    spi_buf[0] = 0x00;
    spi_buf[1] = 0x00;
    spi_buf[2] = 0x00;  //HAL_UART_Transmit(&huart1, (uint8_t *)MSG, sizeof(MSG), HAL_MAX_DELAY);
    spi_buf[3] = 0x00;

    uint8_t rData[4];
//    0111 1111
    rData[0] = 0x7F;
    rData[1] = 0x00;
    rData[2] = 0x00;
    rData[3] = 0x00;

    SPI_429_Transmit(rData, spi_buf);

    uint8_t LData[4];
//    0111 1111
    LData[0] = spi_buf[0];
    LData[1] = spi_buf[1];
    LData[2] = spi_buf[2];
    LData[3] = spi_buf[3];

    int j=0;
//    HAL_UART_Transmit(&huart1, (uint8_t *)MSG, sizeof(MSG), HAL_MAX_DELAY);
}

void read_position(uint8_t * spi_buf, uint8_t reg){
    int j;
    j=0;
    char MSG[500] = {'\0'};
    //j += sprintf(MSG+j, "Output of target setting:0x0%lx\r\n", (uint32_t)(*spi_buf));
    //IDX:0000
    //24 bits position
    spi_buf[0] = ((reg & 0x0F) << 1) + 1;
    spi_buf[1] = 0x00;
    spi_buf[2] = 0x00;  //HAL_UART_Transmit(&huart1, (uint8_t *)MSG, sizeof(MSG), HAL_MAX_DELAY);
    spi_buf[3] = 0x00;

    uint8_t rData[4];
    rData[0] = (uint8_t)(((reg & 0x0F) << 1) + 1);
    rData[1] = 0x00;
    rData[2] = 0x00;
    rData[3] = 0x00;

    SPI_429_Transmit(rData, spi_buf);
    j += sprintf(MSG+j, "REGISTER:%u\n", reg);
    j += sprintf(MSG+j, "VAL_INSIDE:0x0%lx, %lx, %lx \r\n", (uint32_t)(spi_buf[1]), (uint32_t)(spi_buf[2]), (uint32_t)(spi_buf[3]));
    HAL_UART_Transmit(&huart1, (uint8_t *)MSG, sizeof(MSG), HAL_MAX_DELAY);
}

void read_ifx(uint8_t * spi_buf){
    int j;
    j=0;
    char MSG[500] = {'\0'};
    //j += sprintf(MSG+j, "Output of target setting:0x0%lx\r\n", (uint32_t)(*spi_buf));
    //IDX:0000
    //24 bits position
    //0110 1001 ......0 0000 0000
    //6     9
    spi_buf[0] = 0x00;
    spi_buf[1] = 0x00;
    spi_buf[2] = 0x00;  //HAL_UART_Transmit(&huart1, (uint8_t *)MSG, sizeof(MSG), HAL_MAX_DELAY);
    spi_buf[3] = 0x00;

    uint8_t rData[4];
    rData[0] = 0x69;
    rData[1] = 0x00;
    rData[2] = 0x00;
    rData[3] = 0x00;

    SPI_429_Transmit(rData, spi_buf);
    j += sprintf(MSG+j, "VAL_INSIDE IFX:0x0%lx, %lx, %lx \r\n", (uint32_t)(spi_buf[1]), (uint32_t)(spi_buf[2]), (uint32_t)(spi_buf[3]));
    HAL_UART_Transmit(&huart1, (uint8_t *)MSG, sizeof(MSG), HAL_MAX_DELAY);
}

void write_ifx(uint8_t * spi_buf){

    uint8_t wData[4];
    wData[0] = 0x69;
    wData[1] = 0x00;
    wData[2] = 0x00;
    wData[3] = 0x20;

    SPI_429_Transmit(wData, spi_buf);
}

void const_vel_test_429_pos (uint8_t * spi_buf){
	  uint8_t wData[4];

    wData[0] = 0x08;            // SPI = 0000 1000 0000 0000 0000 [0000 0001 0000]
    wData[1] = 0x00;
    wData[2] = 0x00;
    wData[3] = 0x10;
    SPI_429_Transmit(wData, spi_buf);
}

void set_motor_pos(uint32_t position, uint8_t * spi_buf){

	// set motor position: 0 00 0000 0 xxxxxxxx xxxxxxxx xxxxxxxx (24-bit position)
	// set ramp mode: 010 1010 0 (0x54) xxxxxxx(lp) xxxxaaaa(ref_conf) xxxxxxaa(ramp mode)

	 uint8_t wData[4];
	 wData[0] = 0x00;
	 wData[1] = 0x00;
	 wData[2] = 0xCE;
	 wData[3] = 0x40;
	 SPI_429_Transmit(wData, spi_buf);

	 //0x006720 = 180 degrees
	 //0x00CE40

//   read_position(spi_buf, 0);

   HAL_Delay(5000);
//   read_position(spi_buf, 1);


	 wData[0] = 0x00;
	 wData[1] = 0x00;
	 wData[2] = 0x00;
	 wData[3] = 0x00;
	 SPI_429_Transmit(wData, spi_buf);

//   read_position(spi_buf, 0);

   HAL_Delay(5000);
//   read_position(spi_buf, 1);


}

uint32_t set_motor_vel(uint8_t * vel, uint8_t * spi_buf){

    // set velocity mode
    uint8_t wData[4];

    wData[0] = 0x14;            // SPI = $14 00 03 00
    wData[1] = 0x00;
    wData[2] = 0x00;            // ref_conf = (refrnl, softstop, disavle stop r. disable stop 1) = 0b011
    wData[3] = 0x02;          //0x02 velocity mode;

    SPI_429_Transmit(wData, spi_buf);

    // set vel target

    wData[0] = 0x08;
    wData[1] = 0x00;
    wData[2] = vel[2];
    wData[3] = vel[3];

    SPI_429_Transmit(wData, spi_buf);

    return 0;

}


uint32_t set_current_scaling(uint8_t * c_scale){

	uint8_t wData[3];

    wData[0] = 0x0D;            // SPI = $D001F  Current setting: $d001F (max. current) (D000A = 1/3 current)
    wData[1] = 0x01 & (c_scale[2]);
    wData[2] = c_scale[3];//0x0A;
    SPI_2660_Transmit(wData);

    return 0;

}



uint32_t set_motor_x(uint8_t * pos, uint8_t * spi_buf){

    // set ramp mode
    uint8_t wData[4];

    wData[0] = 0x14;            // SPI = $14 00 03 00
    wData[1] = 0x00;
    wData[2] = 0x00;            // ref_conf = (refrnl, softstop, disavle stop r. disable stop 1) = 0b011
    wData[3] = 0x00;          //0x00 ramp mode;

    SPI_429_Transmit(wData, spi_buf);

    // set x target
    wData[0] = 0x00;
    wData[1] = pos[1];
    wData[2] = pos[2];
    wData[3] = pos[3];

    SPI_429_Transmit(wData, spi_buf);

    return 0;

}

void set_const_vel_test(uint8_t * spi_buf){
    uint8_t wData[4];

    //SET TO VELOCITY MODE
    wData[0] = 0x14;            // SPI = $14 00 03 00
    wData[1] = 0x00;
    wData[2] = 0x03;            // ref_conf = (refrnl, softstop, disavle stop r. disable stop 1) = 0b011
    wData[3] = 0x02;          //0x02;
    SPI_429_Transmit(wData, spi_buf);

    //SET VEOLOCITY
    wData[0] = 0x08;            // SPI = 0000 1000 0000 0000 0000 [0000 0001 0000]
    wData[1] = 0x00;
    wData[2] = 0x37;
    wData[3] = 0x10;
    SPI_429_Transmit(wData, spi_buf);
    int cnt = 10;


    while(cnt>0){
      read_position(spi_buf, 1);
      get_position(spi_buf);
      cnt = cnt - 1;
    }

    HAL_Delay(1000);
    //SET BACK TO RAMP MODE
    wData[0] = 0x14;            // SPI = $14 00 03 00
    wData[1] = 0x00;
    wData[2] = 0x03;            // ref_conf = (refrnl, softstop, disavle stop r. disable stop 1) = 0b011
    wData[3] = 0x02;          //0x02;
    SPI_429_Transmit(wData, spi_buf);
}
void get_position(uint8_t * spi_buf){

	spi_buf[0] = 0;
	spi_buf[1] = 0;
	spi_buf[2] = 0;
	spi_buf[3] = 0;

    //24 bits position

//    uint8_t urmum[4];

    uint8_t rData[4];
    rData[0] = 0x03;
    rData[1] = 0x00;
    rData[2] = 0x00;
    rData[3] = 0x00;

    SPI_429_Transmit(rData, spi_buf);
    SPI_429_Transmit(rData, spi_buf);
    SPI_429_Transmit(rData, spi_buf);
    SPI_429_Transmit(rData, spi_buf);
    SPI_429_Transmit(rData, spi_buf);
    SPI_429_Transmit(rData, spi_buf);
    SPI_429_Transmit(rData, spi_buf);
    SPI_429_Transmit(rData, spi_buf);
    SPI_429_Transmit(rData, spi_buf);

    uint8_t uart_data[4];

    uart_data[0] = spi_buf[0];
    uart_data[1] = spi_buf[1];
    uart_data[2] = spi_buf[2];
    uart_data[3] = spi_buf[3];


    HAL_UART_Transmit(&huart1, uart_data, 4, 1000);


//    return spi_buf;
}

uint8_t* get_velocity(uint8_t * spi_buf){
    spi_buf[0] = 0x00;//((reg & 0x0F) << 1) + 1;
    spi_buf[1] = 0x00;
    spi_buf[2] = 0x00;
    spi_buf[3] = 0x00;

    uint8_t rData[4];
    rData[0] = (uint8_t)(((5 & 0x0F) << 1) + 1);
    rData[1] = 0x00;
    rData[2] = 0x00;
    rData[3] = 0x00;

    SPI_429_Transmit(rData, spi_buf);
    return spi_buf;
}

/* USER CODE END 4 */
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
