blmonk/PoE-Stepper-Motor-Driver/code/FINAL CODE/PoE_Stepper_VGT/PoE_Stepper_VGT.ioc

Mcu.UserName=STM32F407VGTx
PA1.Signal=ETH_REF_CLK
PA10.Signal=USART1_RX
PA13.Signal=SYS_JTMS-SWDIO
PA14.Signal=SYS_JTCK-SWCLK
PA15.GPIO_Label=SPI3_CS
PA15.Signal=GPIO_Output
PA2.Signal=ETH_MDIO
PA4.GPIO_Label=SPI1_CS
PA4.Signal=GPIO_Output
PA7.Signal=ETH_CRS_DV
PA9.Signal=USART1_TX
PB11.Signal=ETH_TX_EN
PB12.Signal=ETH_TXD0
PB13.Signal=ETH_TXD1
PB3.Signal=SPI1_SCK
PB4.Signal=SPI1_MISO
PB5.Signal=SPI1_MOSI
PB6.GPIO_Label=CLK_429
PB6.Signal=S_TIM4_CH1
PC1.Signal=ETH_MDC
PC10.Signal=SPI3_SCK
PC11.Signal=SPI3_MISO
PC12.Signal=SPI3_MOSI
PC4.Signal=ETH_RXD0
PC5.Signal=ETH_RXD1
PE2.Signal=GPIO_Output
PE3.Signal=GPIO_Output
PE4.Signal=GPIO_Output
PH0-OSC_IN.Signal=RCC_OSC_IN
PH1-OSC_OUT.Signal=RCC_OSC_OUT
