blmonk/PoE-Stepper-Motor-Driver/code/FINAL CODE/PoE_Stepper_VGT/Core/Inc/main.h

#define SPI1_CS_Pin GPIO_PIN_4
#define SPI1_CS_GPIO_Port GPIOA
#define SPI3_CS_Pin GPIO_PIN_15
#define SPI3_CS_GPIO_Port GPIOA
#define CLK_429_Pin GPIO_PIN_6
#define CLK_429_GPIO_Port GPIOB
