blmonk/PoE-Stepper-Motor-Driver/(commit log)

2022-02-02 added folders and empty kicad project
    [PoE_Stepper_Driver.kicad_pcb, PoE_Stepper_Driver.sch]
2022-02-02 started schematic, added reference files for poe board
    [DC2911A-1-BOM.XLS, DC2911A-1.DSN, DC2911A-1.PCB, PoE_Stepper_Driver.sch]
2022-02-02 started poe side of schematic
    [PoE_Stepper_Driver.sch]
2022-02-17 added ethernet transformer
    [Ethernet.sch, PoE_Stepper_Driver.sch]
2022-02-18 almost done with ethernet schematic, need phy and annotations
    [Ethernet.sch]
2022-02-18 added trinamic chips
    [Ethernet.sch, Motor.sch, Motor_Control.sch, PoE_Stepper_Driver.sch]
2022-02-21 pretty much finished motor subsystem schematic
    [Motor_Control.sch, PoE_Stepper_Driver.sch]
2022-02-22 added phy schematic symbol
    [Ethernet.sch, PoE_Stepper_Driver.sch]
2022-02-22 added actual phy
    [Ethernet.sch, Motor_Control.sch, PoE_Stepper_Driver.sch]
2022-02-25 added dp83848 phy and more caps
    [Ethernet.sch, Motor_Control.sch, PoE_Stepper_Driver.sch]
2022-03-01 started board layout
    [Ethernet.sch, Motor_Control.sch, PoE_Stepper_Driver.sch]
2022-03-01 why tf is gnd connected to vout- bruhh
    [Ethernet.sch, PoE_Stepper_Driver.kicad_pcb]
2022-03-02 fixed ground issue
    [Ethernet.sch, PoE_Stepper_Driver.kicad_pcb, PoE_Stepper_Driver.sch]
2022-03-03 finished footprint assignment
    [Ethernet.sch, Motor_Control.sch, PoE_Stepper_Driver.kicad_pcb, PoE_Stepper_Driver.sch]
2022-03-04 almost finished ethernet layout
    [Motor_Control.sch, PoE_Stepper_Driver.kicad_pcb]
2022-03-04 added programming pins
    [PoE_Stepper_Driver.kicad_pcb, PoE_Stepper_Driver.sch]
2022-03-04 burhhhhh sheeeeeeeeeeeeeeeeeesh
    [Ethernet.sch, PoE_Stepper_Driver.kicad_pcb, PoE_Stepper_Driver.sch]
2022-03-05 Added motor control
    [PoE_Stepper_Driver.kicad_pcb]
2022-03-06 Revert "Added motor control"
    This reverts commit 7b2113a3a06210cf39fce9f6ba2f7b8593b46419.
    [PoE_Stepper_Driver.kicad_pcb]
2022-03-06 putting power on separate board
    [Power_Board.kicad_pcb]
2022-03-06 finished power board
    [PoE_Stepper_Driver.kicad_pcb, PoE_Stepper_Driver.sch]
2022-03-06 finished power board fr
    [Power_Board.kicad_pcb]
2022-03-06 done routing phy signals to mcu
    [PoE_Stepper_Driver.kicad_pcb, Power_Board.kicad_pcb]
2022-03-07 finished 2660 planes
    [PoE_Stepper_Driver.kicad_pcb, PoE_Stepper_Driver.sch]
2022-03-07 finished spi routing
    [PoE_Stepper_Driver.kicad_pcb]
2022-03-07 finished 1st draft of pcb
    [PoE_Stepper_Driver.kicad_pcb]
2022-03-08 added silkscreen info
    [PoE_Stepper_Driver.kicad_pcb, PoE_Stepper_Driver.sch, Power_Board.kicad_pcb]
2022-03-08 added UART
    [PoE_Stepper_Driver.kicad_pcb, PoE_Stepper_Driver.sch]
2022-03-08 fixed weird track
    [PoE_Stepper_Driver.kicad_pcb]
2022-03-08 created gerbers, passed audit
    [PoE_Stepper_Driver-B_Cu.gbr, PoE_Stepper_Driver-B_Mask.gbr, PoE_Stepper_Driver-B_Paste.gbr, PoE_Stepper_Driver-B_SilkS.gbr, PoE_Stepper_Driver-Edge_Cuts.gbr, PoE_Stepper_Driver-F_Cu.gbr, PoE_Stepper_Driver-F_Mask.gbr, PoE_Stepper_Driver-F_Paste.gbr]
2022-03-08 added pwr board gerbers
    [PoE_Stepper_Driver-B_Cu.gbr, PoE_Stepper_Driver-B_Mask.gbr, PoE_Stepper_Driver-B_Paste.gbr, PoE_Stepper_Driver-B_SilkS.gbr, PoE_Stepper_Driver-Edge_Cuts.gbr, PoE_Stepper_Driver-F_Cu.gbr, PoE_Stepper_Driver-F_Mask.gbr, PoE_Stepper_Driver-F_Paste.gbr]
2022-03-30 added working blink code
    [Ethernet.sch, FET_Board.kicad_pcb, Power_Board.kicad_pcb]
2022-03-30 added timers for trinamic clks
    [Motor_Control.sch, PoE_Stepper_Driver.sch]
2022-03-31 made rev2 board changes
    [PoE_Stepper_Driver-B_Cu.gbr, PoE_Stepper_Driver-B_Mask.gbr, PoE_Stepper_Driver-B_Paste.gbr, PoE_Stepper_Driver-B_SilkS.gbr, PoE_Stepper_Driver-Edge_Cuts.gbr, PoE_Stepper_Driver-F_Cu.gbr, PoE_Stepper_Driver-F_Mask.gbr, PoE_Stepper_Driver-F_Paste.gbr]
2022-04-10 got sprrintf to work with uart config
2022-04-17 writing to 429 is working
    [Ethernet.sch, PoE_Stepper_Driver.kicad_pcb, PoE_Stepper_Driver.sch]
2022-04-19 moving to a postition but not correctly :(
    [main.c]
2022-05-06 added final code
    [Ethernet.sch]
