blmonk/PoE-Stepper-Motor-Driver/(notices)

Notices in the files:
code/FINAL CODE/PoE_Stepper_VGT/Core/Src/main.c:
Copyright (c) 2022 STMicroelectronics.
All rights reserved.
This software is licensed under terms that can be found in the LICENSE file
